GOFmugsy/ai-outdoor-light/stl/reflector.stl

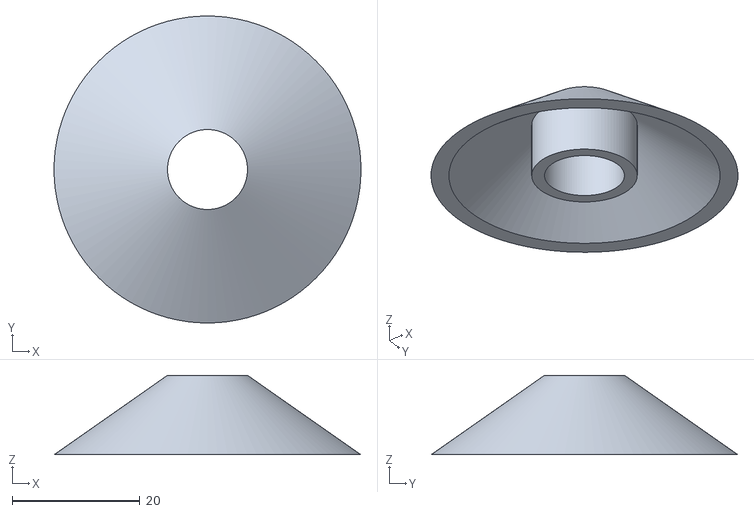
[picture p1: CAD file, 2026-10-22]
stl/reflector.stl
48.0 x 48.0 x 12.4
