GOFmugsy/ai-outdoor-light/stl/diffuser.stl

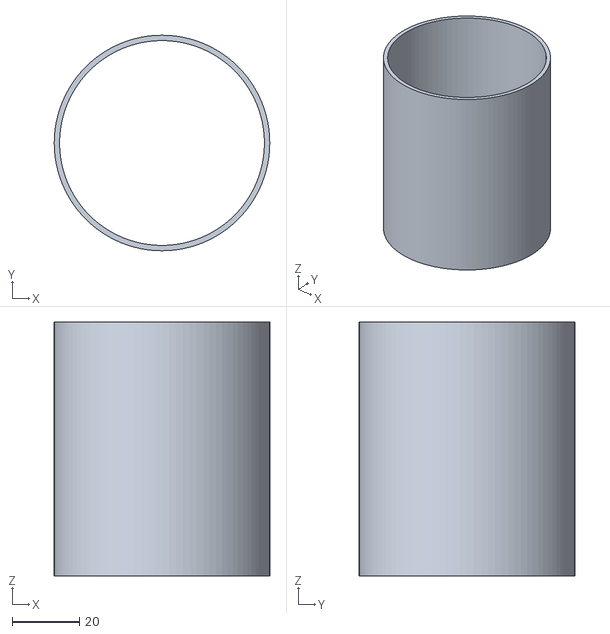
[picture p2: CAD file, 2026-10-22]
stl/diffuser.stl
64.0 x 64.0 x 75.4
