GOFmugsy/ai-outdoor-light/stl/deck.stl

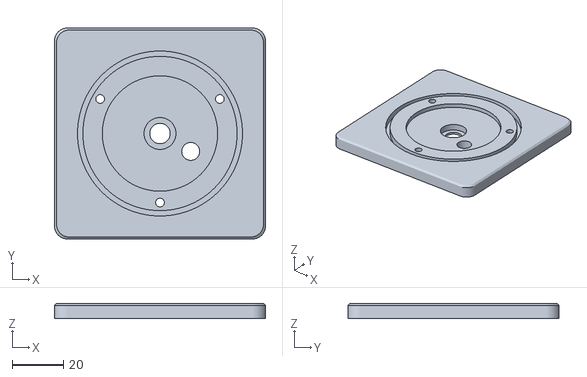
[picture p3: CAD file, 2026-10-22]
stl/deck.stl
82.5 x 82.5 x 6.00
