GOFmugsy/ai-outdoor-light/stl/spine.stl

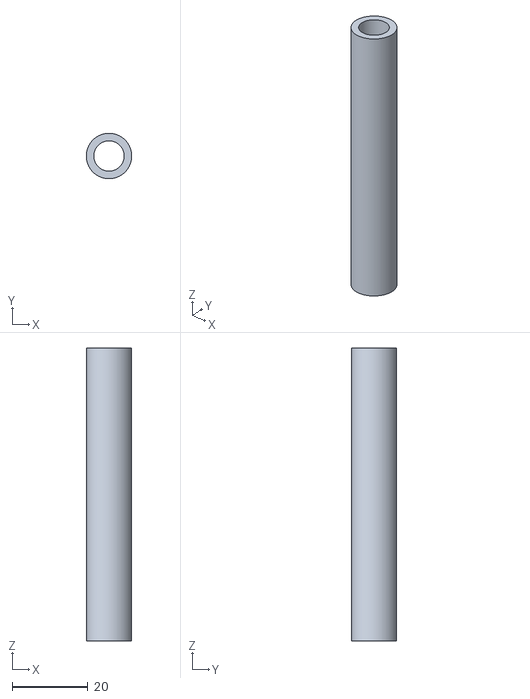
[picture p4: CAD file, 2026-10-22]
stl/spine.stl
12.0 x 12.0 x 77.4
