GOFmugsy/ai-outdoor-light/stl/stake.stl

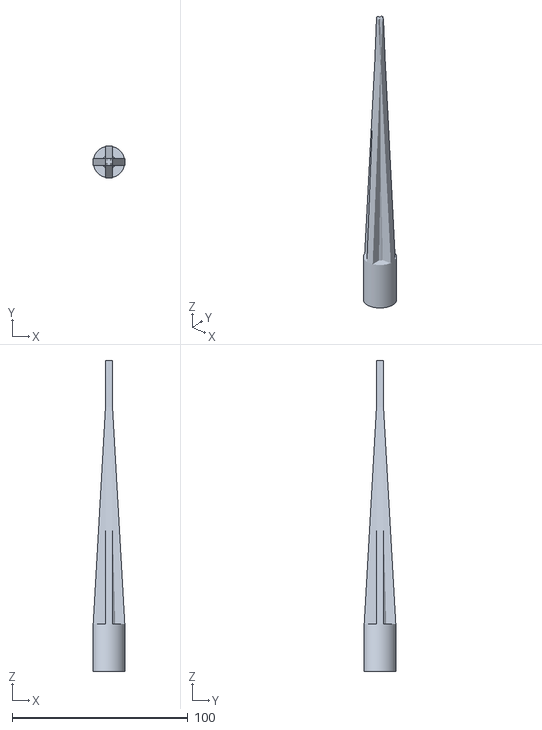
[picture p5: CAD file, 2026-10-22]
stl/stake.stl
18.0 x 18.0 x 177.0
