GOFmugsy/ai-outdoor-light/stl/usb_plug.stl

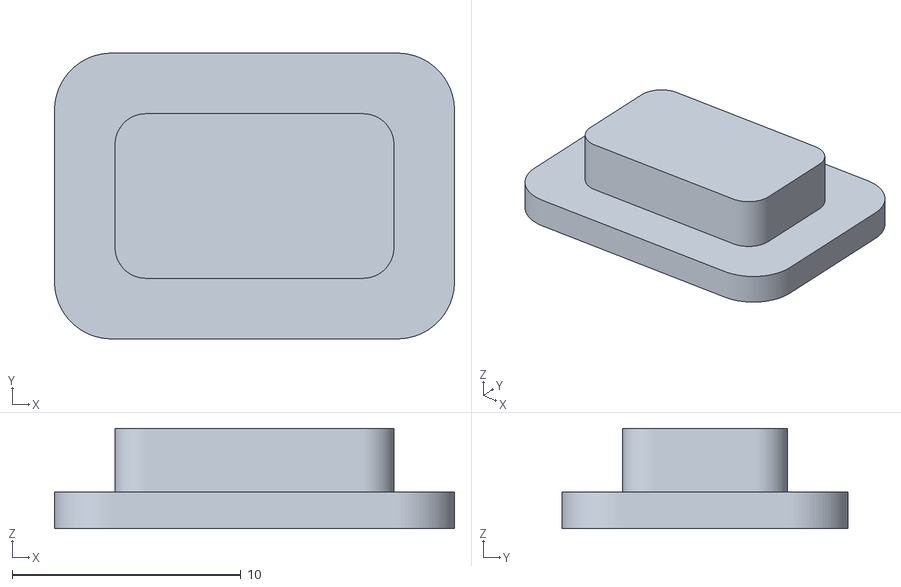
[picture p6: CAD file, 2026-10-22]
stl/usb_plug.stl
17.5 x 12.5 x 4.39
