GOFmugsy/ai-outdoor-light/stl/gasket.stl

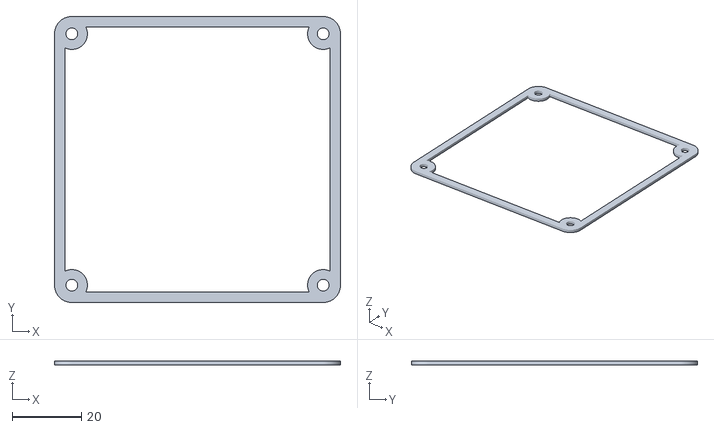
[picture p7: CAD file, 2026-10-22]
stl/gasket.stl
82.5 x 82.5 x 1.20
