GOFmugsy/ai-outdoor-light/stl/base.stl

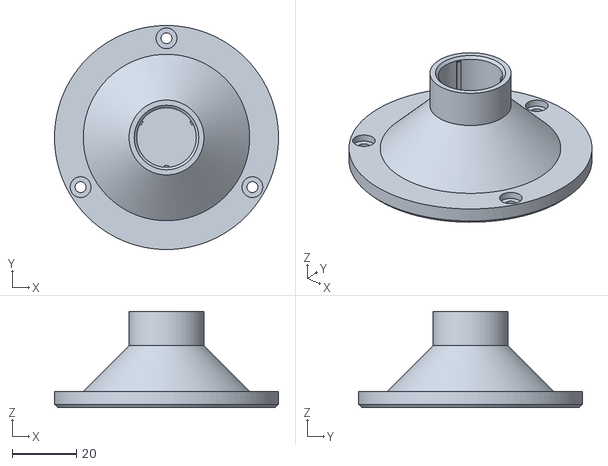
[picture p8: CAD file, 2026-10-22]
stl/base.stl
70.0 x 70.0 x 30.0
