GOFmugsy/ai-outdoor-light/stl/cap.stl

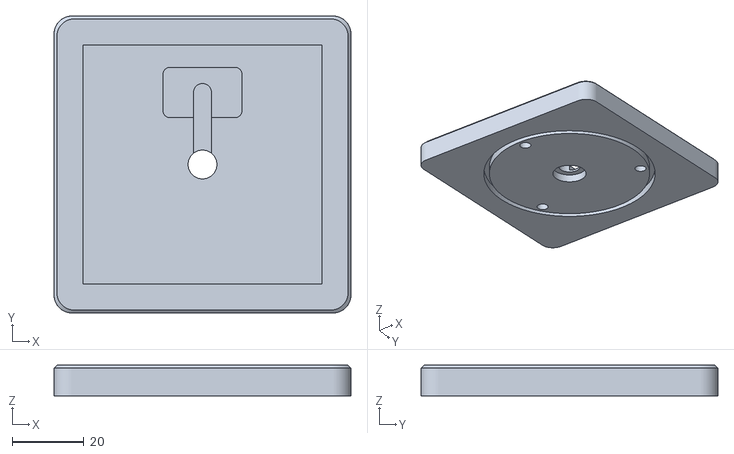
[picture p9: CAD file, 2026-10-22]
stl/cap.stl
82.5 x 82.5 x 8.50
