GOFmugsy/ai-outdoor-light/stl/body.stl

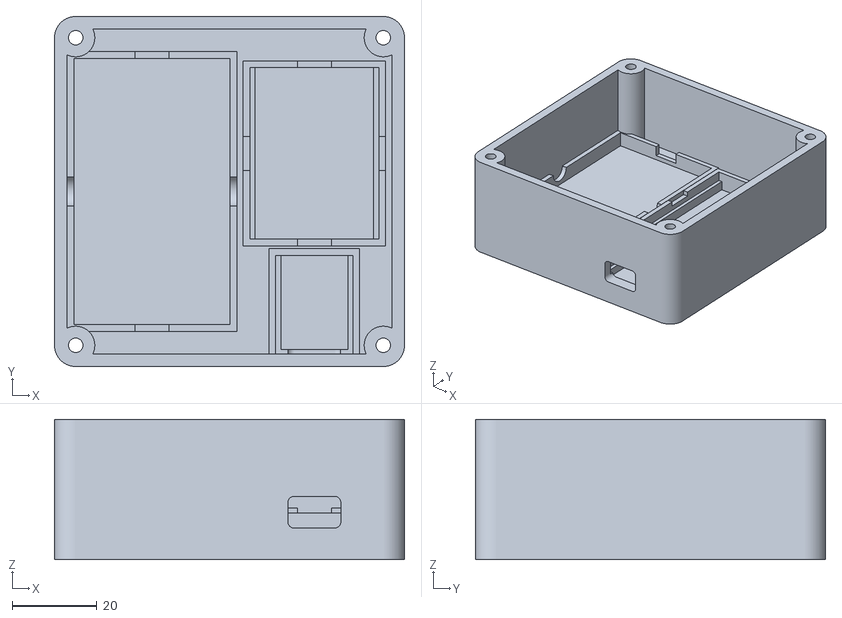
[picture p10: CAD file, 2026-10-22]
stl/body.stl
82.5 x 82.5 x 33.0
